Aran508/n8n/forge-mini/cad/images/arm.png

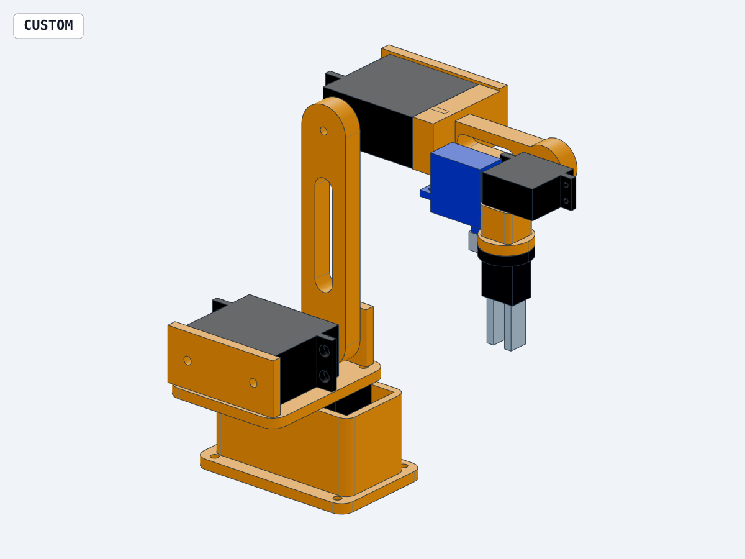
forge-mini/cad/images/arm.png
