Aran508/n8n/forge-mini/cad/STEP/arm/upper_arm.step

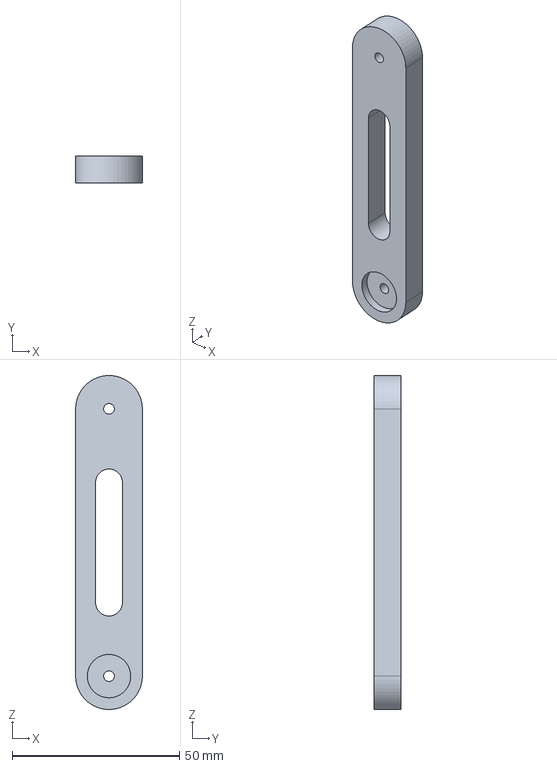
[picture p4: CAD file, 2026-10-25]
forge-mini/cad/STEP/arm/upper_arm.step
20.0 x 8.00 x 100.0 mm
