Aran508/n8n/forge-mini/cad/STEP/cell.step

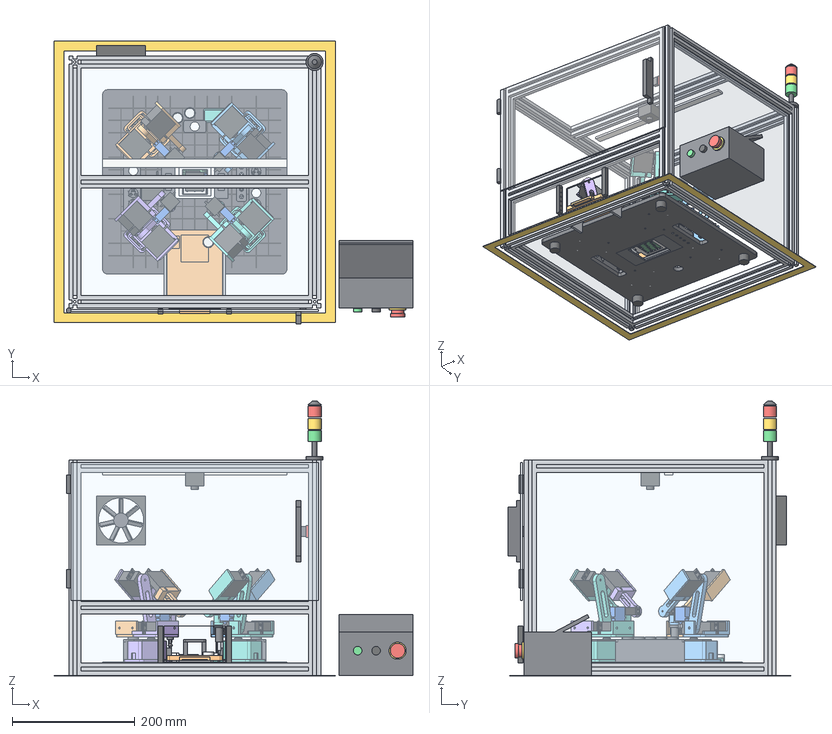
[picture p5: CAD file, 2026-10-25]
forge-mini/cad/STEP/cell.step
584.0 x 460.0 x 447.0 mm
work_plate
feet
arm1_pedestal
arm4_base_servo x 4
arm1_turntable
arm1_shoulder_bracket
arm4_shoulder_servo x 4
arm1_upper_arm
arm4_elbow_servo x 4
arm1_forearm
arm4_wrist_servo x 4
arm1_wrist_hub
part_o1.6.3.4.2.3.3.1 x 4
part_o1.6.3.4.2.3.3.2 x 4
part_o1.6.3.4.2.3.3.3 x 4
arm4_latch_servo x 4
arm4_latch_hook x 4
tool_plate x 11
grip
prongs
arm2_pedestal
arm2_turntable
arm2_shoulder_bracket
arm2_upper_arm
arm2_forearm
arm2_wrist_hub
heater_handle x 2
tip x 2
solder_feed_tube x 2
arm3_pedestal
arm3_turntable
arm3_shoulder_bracket
arm3_upper_arm
arm3_forearm
arm3_wrist_hub
pump_body
nozzle
suction_cup
arm4_pedestal
arm4_turntable
arm4_shoulder_bracket
arm4_upper_arm
arm4_forearm
arm4_wrist_hub
rack_L x 2
rack_B
housing x 2
jaws x 2
holder
pen_tip
switch_body
stylus
arm
rubber_pad
n20_motor
magnetic_collet
syringe
luer_hub
needle
bit_block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
