Aran508/n8n/forge-mini/cad/STEP/cell/rack_b.step

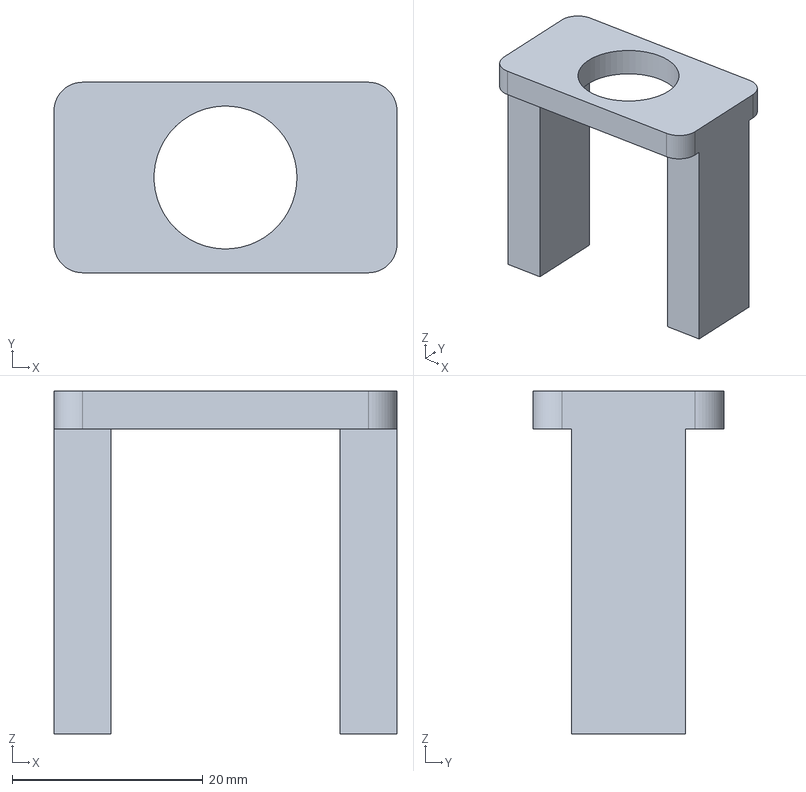
[picture p6: CAD file, 2026-10-25]
forge-mini/cad/STEP/cell/rack_b.step
36.0 x 20.0 x 36.0 mm
