Aran508/n8n/forge-mini/cad/STEP/tools/tool_clamp.step

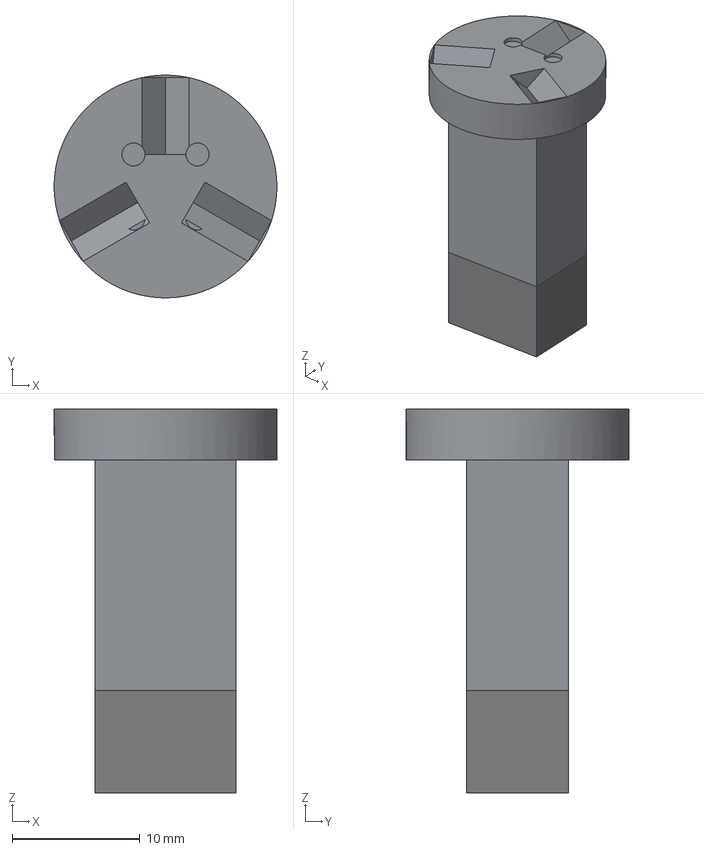
[picture p7: CAD file, 2026-10-25]
forge-mini/cad/STEP/tools/tool_clamp.step
17.4 x 17.4 x 30.0 mm
tool_plate
arm
rubber_pad
