Aran508/n8n/forge-mini/cad/STEP/arm.step

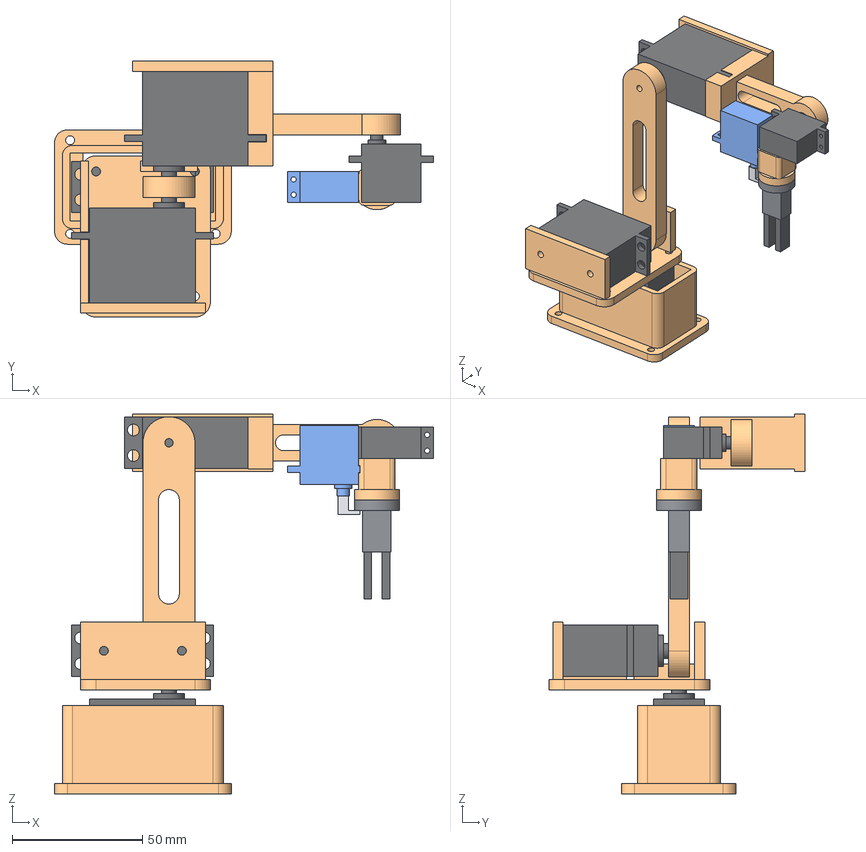
[picture p8: CAD file, 2026-10-25]
forge-mini/cad/STEP/arm.step
145.8 x 98.5 x 146.0 mm
arm_pedestal
arm_elbow_servo x 3
arm_turntable
arm_shoulder_bracket
arm_upper_arm
arm_forearm
arm_wrist_servo
arm_wrist_hub
part_o1.3.4.2.3.3.3 x 3
arm_latch_servo
arm_latch_hook
tool_plate
housing
jaws
