Aran508/n8n/forge-mini/cad/STEP/arm/forearm.step

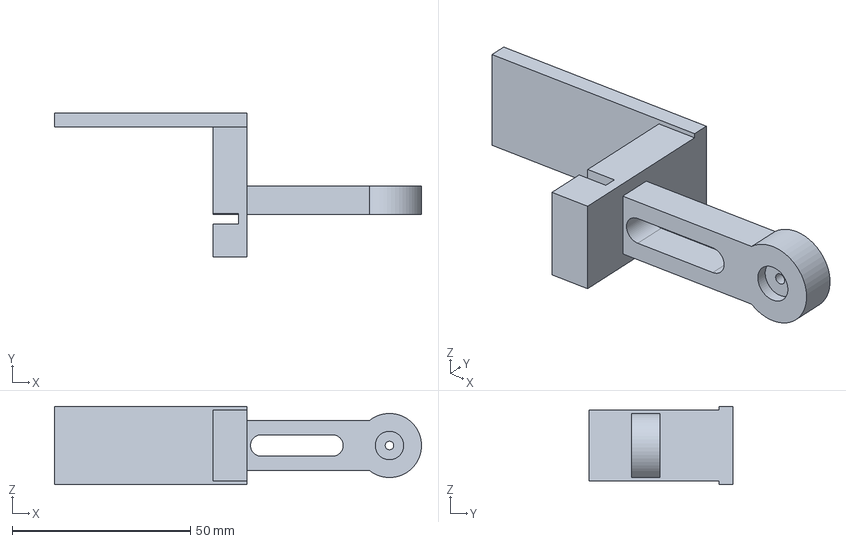
[picture p9: CAD file, 2026-10-25]
forge-mini/cad/STEP/arm/forearm.step
103.0 x 40.5 x 22.0 mm
