Aran508/n8n/forge-mini/cad/STEP/cell/work_plate.step

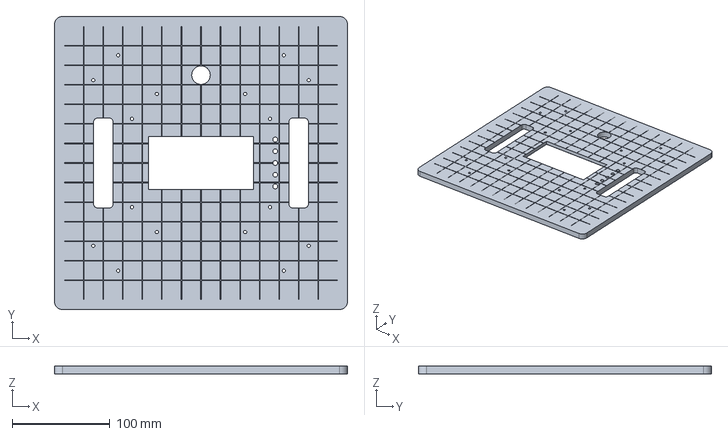
[picture p10: CAD file, 2026-10-25]
forge-mini/cad/STEP/cell/work_plate.step
300.0 x 300.0 x 8.00 mm
