Aran508/n8n/forge-mini/cad/STEP/tools/tool_vacuum.step

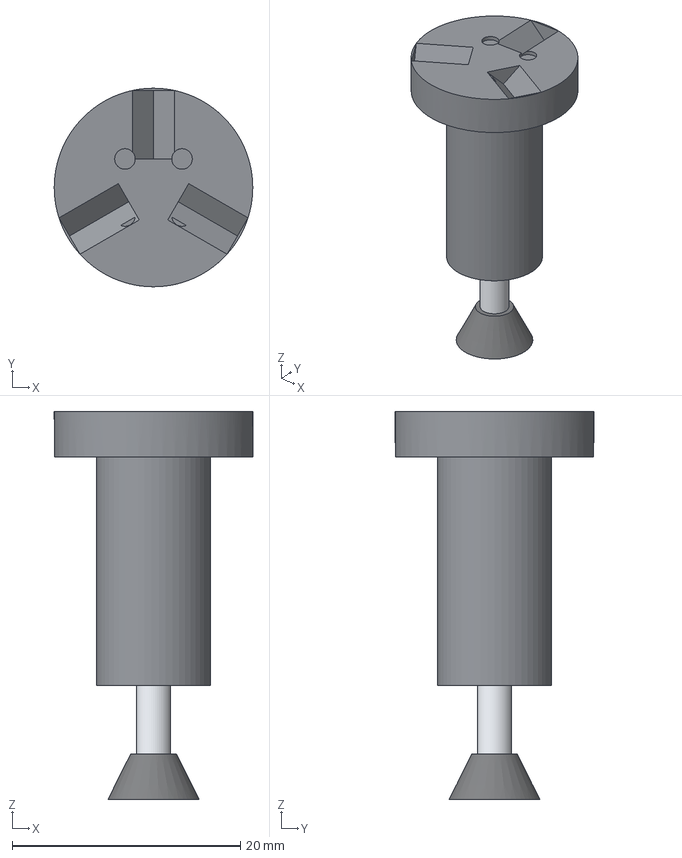
[picture p11: CAD file, 2026-10-25]
forge-mini/cad/STEP/tools/tool_vacuum.step
17.4 x 17.4 x 34.0 mm
tool_plate
pump_body
nozzle
suction_cup
