Aran508/n8n/forge-mini/cad/STEP/arm/shoulder_bracket.step

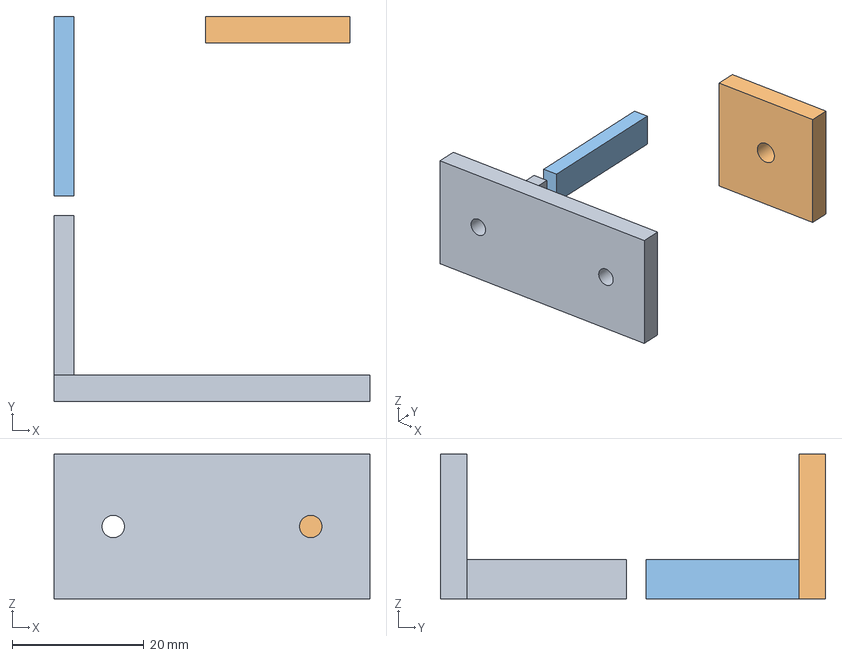
[picture p12: CAD file, 2026-10-25]
forge-mini/cad/STEP/arm/shoulder_bracket.step
48.0 x 58.5 x 22.0 mm
