Aran508/n8n/forge-mini/cad/STEP/cell/flip_cradle.step

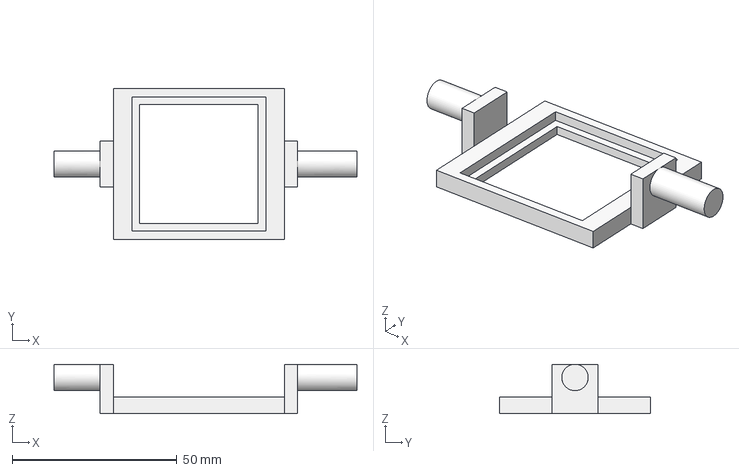
[picture p13: CAD file, 2026-10-25]
forge-mini/cad/STEP/cell/flip_cradle.step
92.0 x 46.0 x 15.0 mm
