Aran508/n8n/forge-mini/cad/STEP/tools/tool_dispenser.step

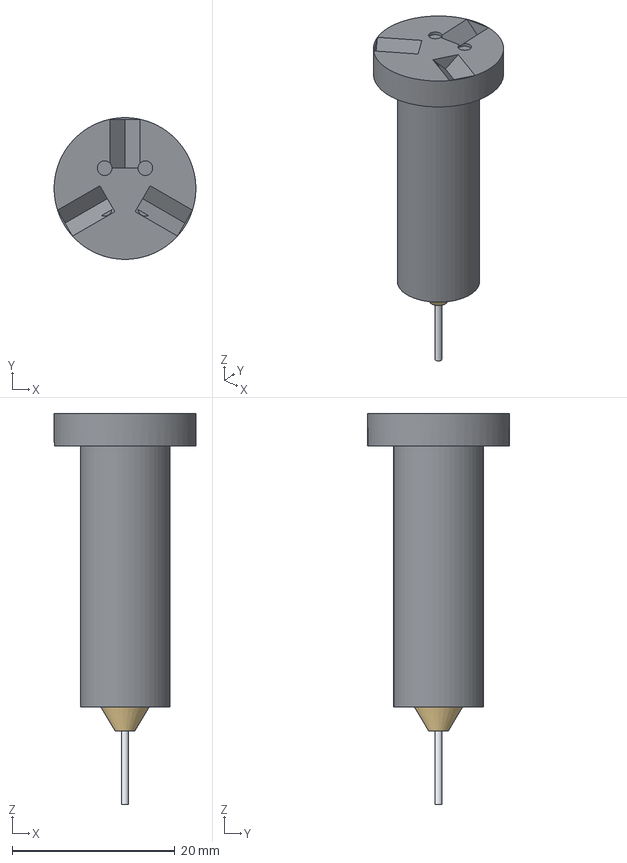
[picture p14: CAD file, 2026-10-25]
forge-mini/cad/STEP/tools/tool_dispenser.step
17.4 x 17.4 x 48.0 mm
tool_plate
syringe
luer_hub
needle
