Aran508/n8n/forge-mini/cad/STEP/arm/wrist_hub.step

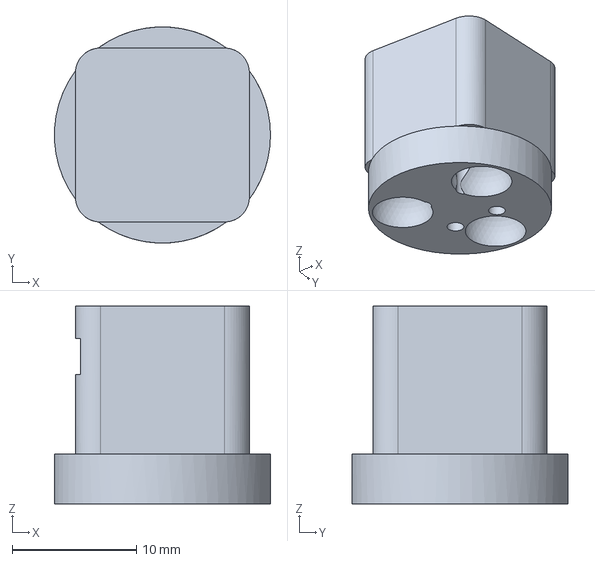
[picture p15: CAD file, 2026-10-25]
forge-mini/cad/STEP/arm/wrist_hub.step
17.4 x 17.4 x 15.9 mm
