Aran508/n8n/forge-mini/cad/STEP/cell/flip_fixture.step

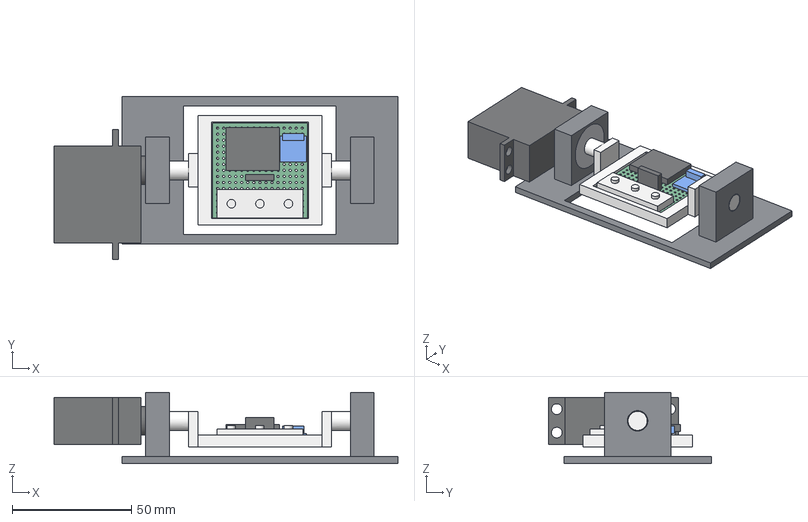
[picture p16: CAD file, 2026-10-25]
forge-mini/cad/STEP/cell/flip_fixture.step
144.5 x 68.4 x 30.0 mm
flip_base
flip_bearings
flip_servo
flip_cradle_frame
watch_perfboard
watch_esp32c3
watch_charger
watch_buttons
watch_oled_socket
