Aran508/n8n/forge-mini/cad/STEP/tools/tool_iron.step

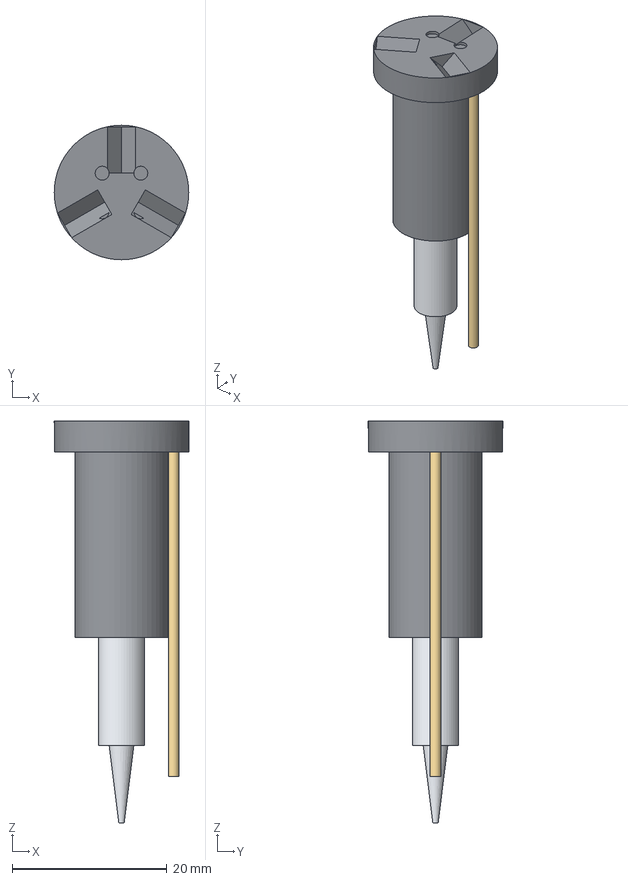
[picture p17: CAD file, 2026-10-25]
forge-mini/cad/STEP/tools/tool_iron.step
17.4 x 17.4 x 52.0 mm
tool_plate
heater_handle
tip
solder_feed_tube
