Aran508/n8n/forge-mini/cad/STEP/arm/pedestal.step

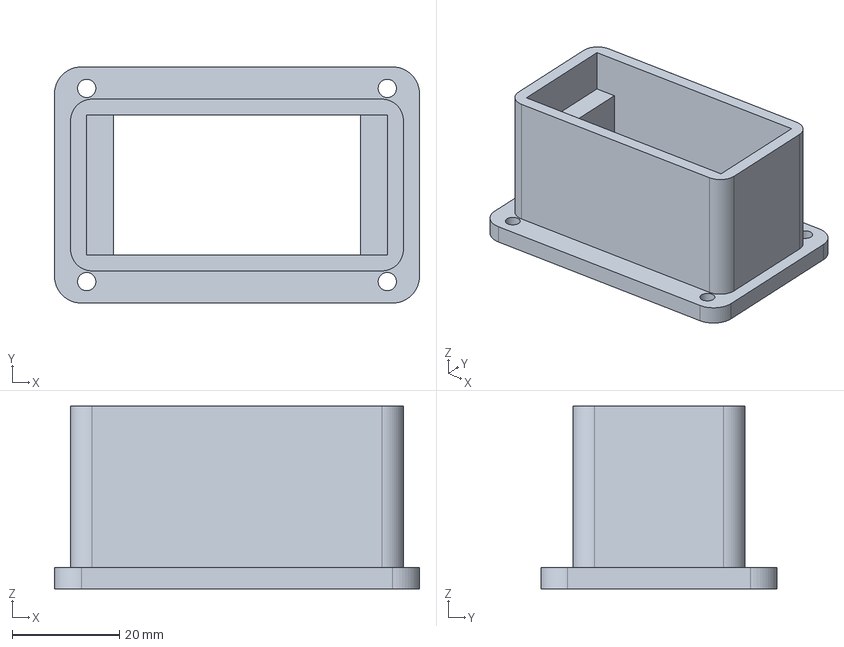
[picture p18: CAD file, 2026-10-25]
forge-mini/cad/STEP/arm/pedestal.step
68.0 x 44.0 x 34.0 mm
