Aran508/n8n/forge-mini/cad/STEP/cell/kit_drawer.step

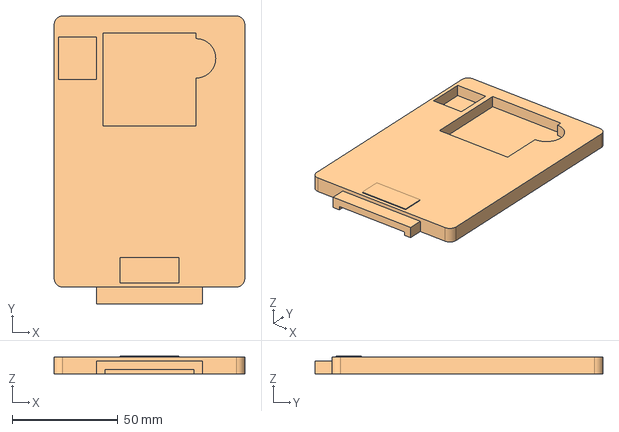
[picture p19: CAD file, 2026-10-25]
forge-mini/cad/STEP/cell/kit_drawer.step
90.0 x 136.0 x 8.40 mm
