Aran508/n8n/forge-mini/cad/STEP/tools/tool_spindle.step

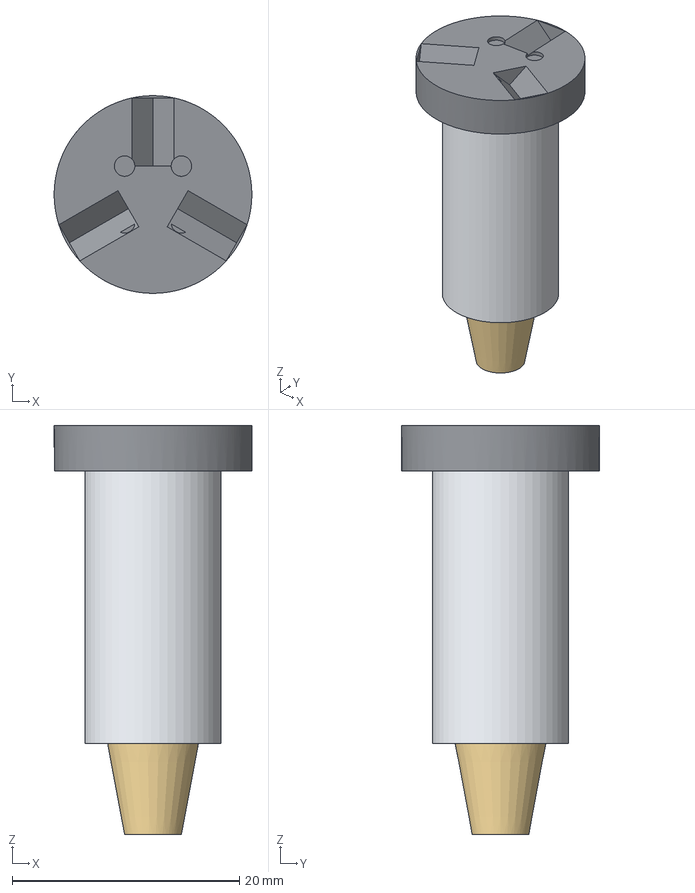
[picture p20: CAD file, 2026-10-25]
forge-mini/cad/STEP/tools/tool_spindle.step
17.4 x 17.4 x 36.0 mm
tool_plate
n20_motor
magnetic_collet
