Aran508/n8n/forge-mini/cad/STEP/arm/turntable.step

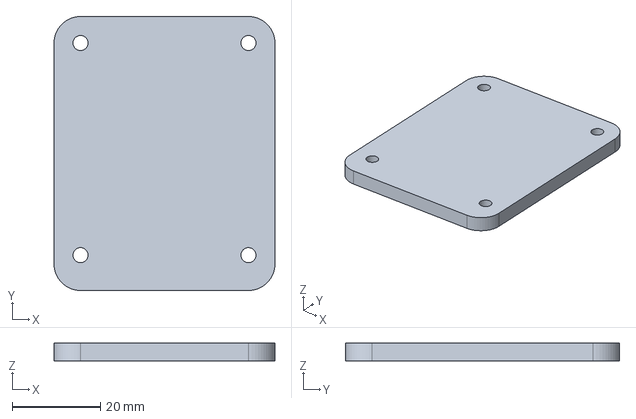
[picture p21: CAD file, 2026-10-25]
forge-mini/cad/STEP/arm/turntable.step
50.0 x 62.0 x 4.00 mm
