Aran508/n8n/forge-mini/cad/STEP/cell/bit_block.step

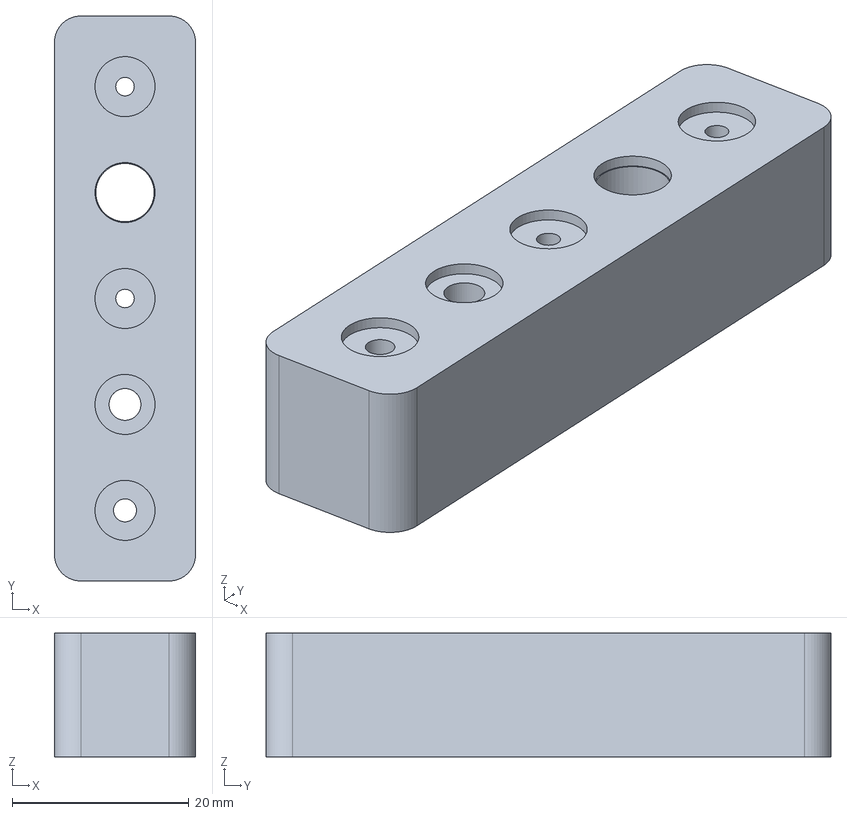
[picture p22: CAD file, 2026-10-25]
forge-mini/cad/STEP/cell/bit_block.step
16.0 x 64.0 x 14.0 mm
