Aran508/n8n/forge-mini/cad/STEP/cell/enclosure.step

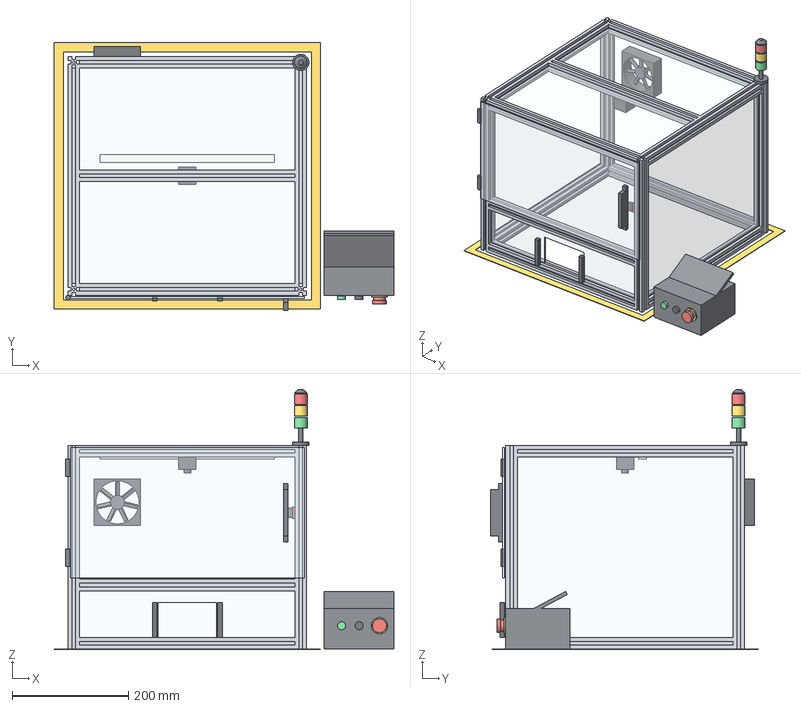
[picture p24: CAD file, 2026-10-25]
forge-mini/cad/STEP/cell/enclosure.step
584.0 x 460.0 x 447.0 mm
enclosure_frame
acrylic_panels
door_pane
door_hardware
door_reed_switch
light_curtain_emitter
light_curtain_receiver
tower_pole
tower_green
tower_yellow
tower_red
tower_cap
overhead_led_bar
camera_1080p
fume_fan
fan_blades
console
hmi_7in
start_button
stop_button
estop_ring
estop
floor_marking
