Aran508/n8n/forge-mini/cad/STEP/tools/tool_pen.step

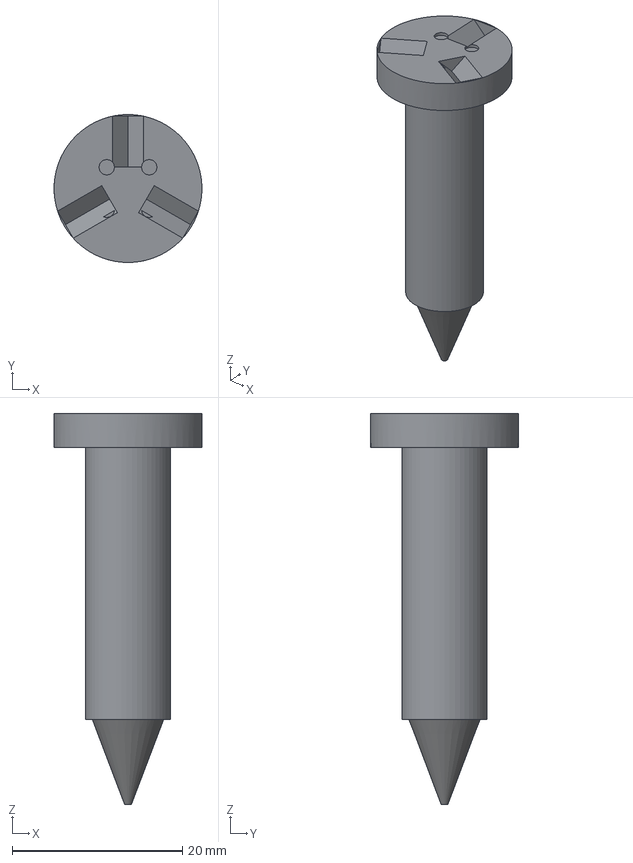
[picture p25: CAD file, 2026-10-25]
forge-mini/cad/STEP/tools/tool_pen.step
17.4 x 17.4 x 46.0 mm
tool_plate
holder
pen_tip
