Aran508/n8n/forge-mini/cad/STEP/cell/flip_base.step

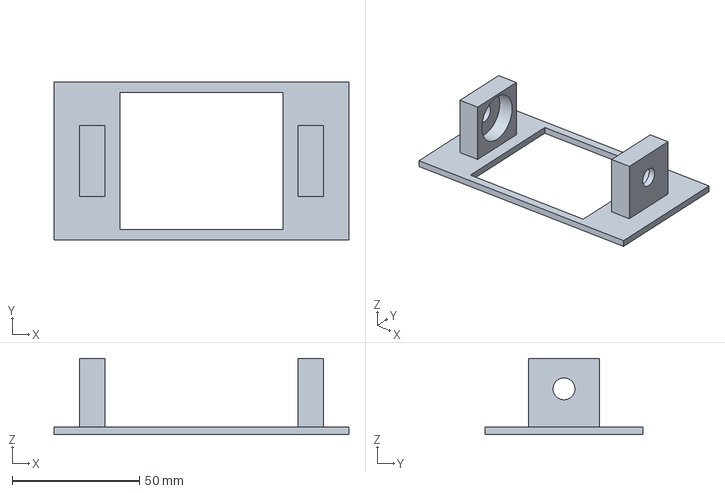
[picture p26: CAD file, 2026-10-25]
forge-mini/cad/STEP/cell/flip_base.step
116.0 x 62.0 x 30.0 mm
