Aran508/n8n/forge-mini/cad/STEP/tools/tool_tweezers.step

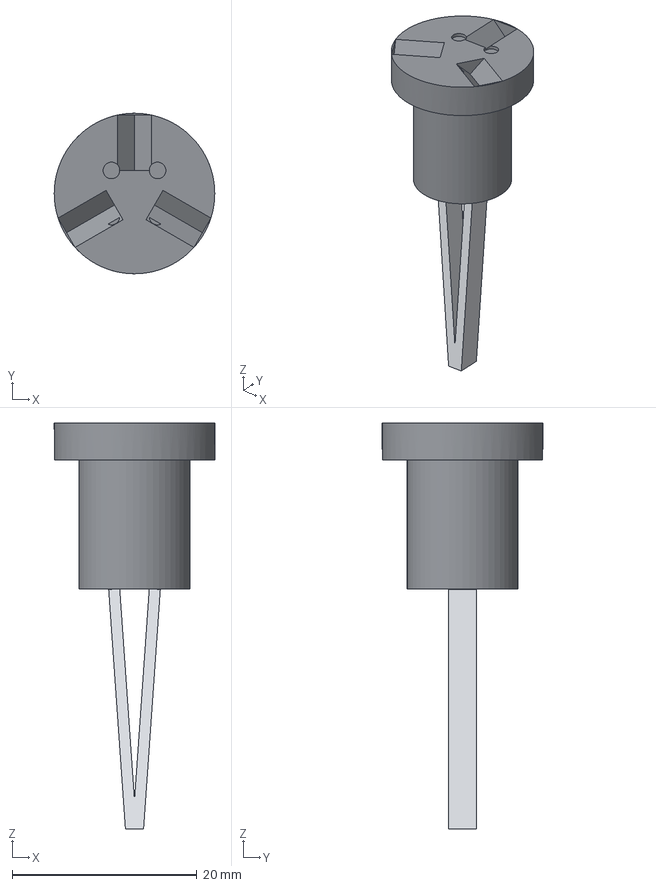
[picture p27: CAD file, 2026-10-25]
forge-mini/cad/STEP/tools/tool_tweezers.step
17.4 x 17.4 x 44.0 mm
tool_plate
grip
prongs
