Aran508/n8n/forge-mini/cad/STEP/cell/rack.step

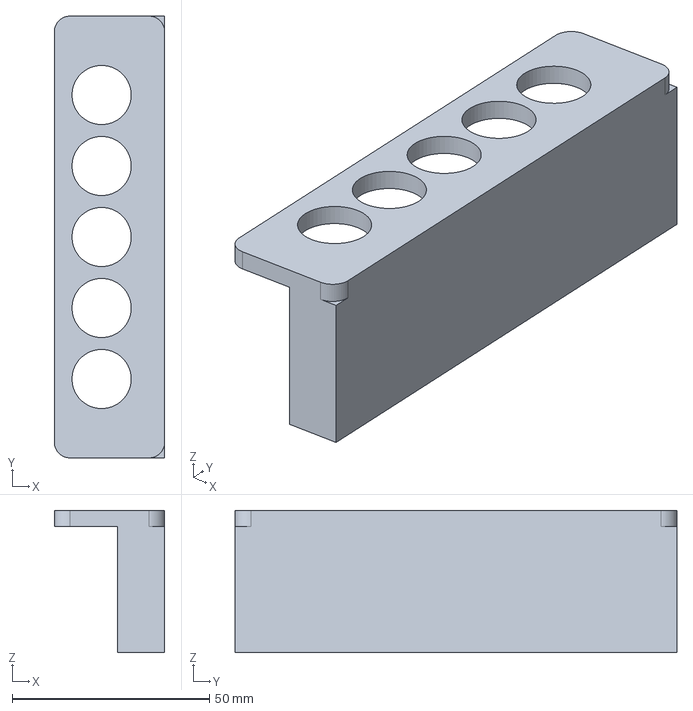
[picture p28: CAD file, 2026-10-25]
forge-mini/cad/STEP/cell/rack.step
28.0 x 112.0 x 36.0 mm
