Aran508/n8n/forge-mini/cad/STEP/tools/tool_gripper.step

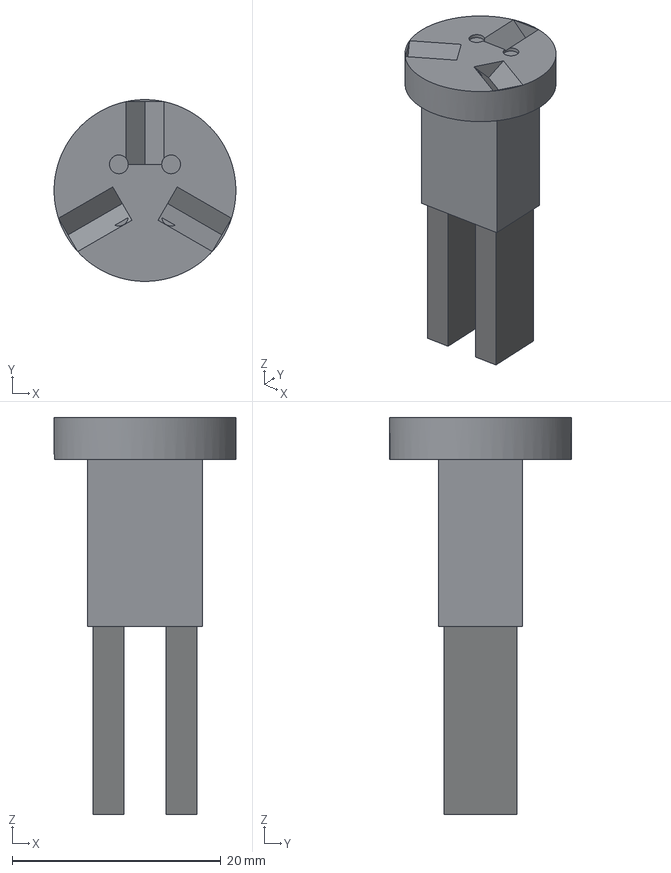
[picture p29: CAD file, 2026-10-25]
forge-mini/cad/STEP/tools/tool_gripper.step
17.4 x 17.4 x 38.0 mm
tool_plate
housing
jaws
