Aran508/n8n/(list of files, cad)

Other CAD files:
forge-mini/cad/STEP/purchased/servo_mg90s.step
forge-mini/cad/STEP/purchased/servo_mg996r.step
forge-mini/cad/STEP/purchased/servo_sg90.step
forge-mini/cad/STL/arm/forearm.stl
forge-mini/cad/STL/arm/pedestal.stl
forge-mini/cad/STL/arm/shoulder_bracket.stl
forge-mini/cad/STL/arm/turntable.stl
forge-mini/cad/STL/arm/upper_arm.stl
forge-mini/cad/STL/arm/wrist_hub.stl
forge-mini/cad/STL/cell/bit_block.stl
forge-mini/cad/STL/cell/flip_base.stl
forge-mini/cad/STL/cell/flip_cradle.stl
forge-mini/cad/STL/cell/kit_drawer.stl
forge-mini/cad/STL/cell/rack.stl
forge-mini/cad/STL/cell/rack_b.stl
forge-mini/cad/STL/tools/tool_clamp.stl
forge-mini/cad/STL/tools/tool_dispenser.stl
forge-mini/cad/STL/tools/tool_gripper.stl
forge-mini/cad/STL/tools/tool_iron.stl
forge-mini/cad/STL/tools/tool_pen.stl
forge-mini/cad/STL/tools/tool_probe.stl
forge-mini/cad/STL/tools/tool_spindle.stl
forge-mini/cad/STL/tools/tool_tweezers.stl
forge-mini/cad/STL/tools/tool_vacuum.stl
