Aran508/n8n/forge-mini/controller/forge/cli.py

"""Command line: forge budget | ik | plan | export | run"""

from __future__ import annotations

import argparse
import json
import sys
from pathlib import Path

import yaml

from .budget import precision_report, report
from .config import load_cell
from .kinematics import Unreachable, inverse
from .planner import PlanError, Planner


def load_recipe(path: str) -> dict:
    return yaml.safe_load(Path(path).read_text())


def plan_file(cell, path):
    recipe = load_recipe(path)
    return recipe, Planner(cell, recipe.get("arms")).plan(recipe)


def export_payload(cell, recipe: dict, timeline) -> dict:
    """Everything the 3D viewer needs: geometry, layout, tools and the timed motion."""
    arms = recipe.get("arms") or list(cell.arms)
    return {
        "product": recipe.get("product"),
        "cell": {
            "links": cell.raw["links"],
            "arms": {n: {"base": a.base, "yaw": a.yaw, "role": a.role} for n, a in cell.arms.items() if n in arms},
            "tools": {n: {"type": t.type, "rack": t.rack, "slot": t.slot, "length": t.length} for n, t in cell.tools.items()},
            "racks": cell.racks,
            "bits": {n: {"kind": b.kind, "dia": b.dia, "stickout": b.stickout, "slot": b.slot} for n, b in cell.bits.items()},
            "bit_block": cell.bit_block,
            "zones": cell.zones,
            "locations": cell.raw["locations"],
            "lock": cell.lock,
            "flipper": cell.raw.get("flipper"),
        },
        **timeline.to_dict(),
    }


def main(argv: list[str] | None = None) -> int:
    p = argparse.ArgumentParser(prog="forge")
    p.add_argument("--cell", default=None, help="path to cell.yaml")
    sub = p.add_subparsers(dest="cmd", required=True)
    sub.add_parser("budget", help="reach, servo torque per tool, and reaming feed force")
    sub.add_parser("tools", help="list the tool racks and the bit block")
    sub.add_parser("precision", help="tool-tip accuracy and which assembly jobs it allows")
    ik = sub.add_parser("ik", help="joint + servo angles for one target")
    ik.add_argument("arm")
    ik.add_argument("x", type=float)
    ik.add_argument("y", type=float)
    ik.add_argument("z", type=float)
    ik.add_argument("--tool", default=None, help="mounted tool (changes the TCP length)")
    pl = sub.add_parser("plan", help="validate a recipe in the digital twin")
    pl.add_argument("recipe")
    ex = sub.add_parser("export", help="plan and write the timeline JSON for the 3D viewer")
    ex.add_argument("recipe")
    ex.add_argument("-o", "--out", required=True)
    run = sub.add_parser("run", help="plan, then play on the real machine")
    run.add_argument("recipe")
    run.add_argument("--port", required=True, help="e.g. /dev/ttyUSB0")
    run.add_argument("--camera", type=int, default=None, help="camera index for inspections")
    run.add_argument("--flash-port", default=None, help="USB port the product appears on when docked, e.g. /dev/ttyACM0")
    run.add_argument("--firmware-dir", default="firmware", help="folder with the product firmware images")
    args = p.parse_args(argv)

    cell = load_cell(args.cell) if args.cell else load_cell()

    if args.cmd == "budget":
        print(report(cell))
        return 0

    if args.cmd == "precision":
        print(precision_report(cell))
        return 0

    if args.cmd == "tools":
        for rack, spec in cell.racks.items():
            print(f"{rack} (arms {', '.join(spec['arms'])}):")
            for t in cell.tools.values():
                if t.rack == rack:
                    print(f"  {t.name:<10} {t.type:<9} {t.length:>4.0f} mm  {t.mass:>3.0f} g  id {t.id_ohms} ohm")
        print(f"bit block (arms {', '.join(cell.bit_block['arms'])}):")
        for b in cell.bits.values():
            print(f"  {b.name:<10} {b.kind:<12} {b.dia:>4.1f} mm  stickout {b.stickout:.0f} mm")
        return 0

    if args.cmd == "ik":
        arm = cell.arms[args.arm]
        try:
            l3 = cell.links.coupler + (cell.tools[args.tool].length if args.tool else 0)
            joints = inverse(cell, arm, (args.x, args.y, args.z), cell.motion["tool_pitch"], 0, l3)
        except Unreachable as e:
            print(f"unreachable: {e}")
            return 1
        print("joints:", joints)
        print("servos:", cell.joints_to_servos(arm, joints))
        return 0

    try:
        recipe, timeline = plan_file(cell, args.recipe)
    except PlanError as e:
        print(f"PLAN REJECTED: {e}", file=sys.stderr)
        return 2

    if args.cmd == "plan":
        steps = sorted((e for e in timeline.events if e.type == "step"), key=lambda e: e.t)
        print(f"OK: {recipe.get('product')} plans cleanly, {len(steps)} steps, "
              f"{len(timeline.segments)} moves, {timeline.duration:.1f}s ({timeline.stats['schedule']} schedule)")
        for e in steps:
            who = e.data.get("arm") or "cell"
            print(f"  {e.t:6.2f}s  {e.data['index']:>2}. [{who}] {e.data['label']}")
        print("  busy: " + "  ".join(f"{a} {p}%" for a, p in timeline.stats["busy_pct"].items()))
        if timeline.stats["schedule"] == "auto":
            seq = Planner(cell, recipe.get("arms")).plan({**recipe, "schedule": "sequential"})
            saved = 100 * (1 - timeline.duration / seq.duration)
            print(f"  one step at a time would take {seq.duration:.1f}s; auto schedule saves {saved:.0f}%")
        return 0

    if args.cmd == "export":
        Path(args.out).write_text(json.dumps(export_payload(cell, recipe, timeline)))
        print(f"wrote {args.out} ({timeline.duration:.1f}s)")
        return 0

    if args.cmd == "run":
        from .executor import SerialLink, play

        inspector = None
        if args.camera is not None:
            from .vision import Camera, make_inspector

            inspector = make_inspector(Camera(args.camera))
        flasher = None
        if args.flash_port:
            from .programmer import make_flasher

            flasher = make_flasher(args.flash_port, args.firmware_dir)
        link = SerialLink(args.port)
        try:
            play(cell, timeline, link, inspector, flasher=flasher)
        finally:
            link.send({"cmd": "relax"})
            link.close()
        return 0
    return 1


if __name__ == "__main__":
    sys.exit(main())
