Aran508/n8n/(commit log)

2026-10-22 Add Forge Mini: 4-arm servo micro-factory prototype
    Controller (IK, recipe planner with zone collision checks, serial
    executor, ArUco vision, MCP server for Claude), ESP32 firmware, week-by-week
    recipes, arm design and build docs, and a 3D simulation viewer that plays
    the planner's timelines.
    Claude-Session: https://claude.ai/code/session_011HSEbQMEbbmkt4sJEQtQvX
    [budget.py, cell.yaml, cli.py, config.py, executor.py, forge_esp32.ino]
2026-10-22 Forge Mini: automatic tool changers, tool racks and reamer/bit block; drop the conveyor
    Each arm now ends in a kinematic coupler with a servo latch and an ID resistor
    line. Two shared racks hold eight tools (grippers, vacuum, pen, probe, clamp,
    spindle, glue) and a bit block holds reamers, a drill, a countersink and a hex
    bit. The planner tracks every tool, bit and part, solves IK with the mounted
    tool's length, enforces rack/tray/fixture zones, and adds tool_change,
    bit_change, machine, draw and probe actions. The executor verifies each tool
    change by its ID resistor. New first product: a reamed, doweled bracket.
    Claude-Session: https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
    [budget.py, cell.yaml, cli.py, config.py, executor.py]
2026-10-22 Forge Mini: keep all arms busy with an auto scheduler; add drone, desk-bot and LED-bar projects
    The planner now schedules steps as early as their arm, parts, tools, shared
    zones and a 20 mm tool-to-tool clearance (checked every 50 ms) allow, instead
    of strictly one after another. Nearby work on the same part keeps recipe
    order; whole-part steps (place, hold, release, inspect, unload) act as
    barriers. forge plan reports per-arm busy time and the sequential comparison.
    Adds a soldering iron and tweezers (5 slots per rack), solder and drive
    actions, and three projects modelled on DIY builds: a 65 mm micro-drone, a
    desk robot head with an OLED face and an LED bar soldered helping-hands style.
    A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
    [cell.yaml, cli.py, mcp_server.py]
2026-10-23 Forge Mini: flip fixture for underside work, precision analysis, miniature safety cell
    Planner: a flip action turns the part 180 degrees in a trunnion fixture so
    arms can solder, screw or mark the underside. It requires clamps released,
    keeps every arm out of the fixture zone while turning, and refuses to unload
    a part that is still upside down. The LED bar is now true through-hole:
    insert from the top, flip, solder 8 legs underneath, flip back.
    forge precision computes tool-tip accuracy from the arm geometry and servo
    angle error (hobby, hobby + camera, smart servos, smart + camera) and which
    assembly jobs each level can do.
    Firmware and executor add the miniature robot cell: door reed-sw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
    [budget.py, cell.yaml, cli.py, executor.py, forge_esp32.ino, mcp_server.py]
2026-10-23 Forge Mini: plan the perfboard ESP32-C3 smartwatch in the cell
    Adds a recipe generator for the smartwatch from the user's video: 40x40 mm
    perfboard, ESP32-C3 SuperMini, USB-C charger, OLED on a socket, 3 buttons,
    P-MOSFET switch. The cell places every part, solders 4 charger pads on top,
    flips, solders 39 legs and 7 drag-soldered tracks underneath with two irons
    at once, fits the OLED, flashes and self-tests the firmware through a USB-C
    dock, waits for a person to plug in the battery, then fits the back cover
    with screws driven from below. ~342 s vs 476 s one step at a time.
    Planner: recipe-local locations; trace, flash and operator actions; a
    person's step freezes all arms and the fixture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
    [cell.yaml, cli.py, executor.py, forge_esp32.ino, make_smartwatch.py, planner.py, programmer.py]
2026-10-25 Forge Mini: parametric CAD of the whole cell (text-to-cad)
    Four 4-DOF servo arms with tool changers, eleven tools, racks, bit block,
    flip fixture with the smartwatch board, work plate, kit drawer, trays and
    the enclosure, all dimensioned from controller/cell.yaml. STEP with joint
    sliders and poses, STL for every printed part, plus an interference check
    (0 overlaps, tool tips match the planner) and a cell.yaml drift check.
    Tool-changer plates are 17.4 mm so neighbouring tools fit the 18 mm slot pitch.
    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
    [arm.step, bit_block.step, bit_block.stl, cell.step, enclosure.step, flip_base.step, flip_base.stl, flip_cradle.step]
